Asaf66/Drone_ESP32/docs/Rev2_Design_Review.md

# סקירת תכנון – Drone_ESP32 Rev 2

תאריך: 2026-10-27. הבסיס: עותק של הקבצים בתיקייה הראשית כפי שהיו ב‑27/10 20:15, כולל השינויים שעוד לא נשמרו ב‑git (ראו "בסיס" למטה).
כלים: ‏kicad-cli 10.0.2 (ERC/DRC/netlist), ובדיקה ידנית מול הדאטהשיטים בתיקייה `DATA SHEET`.

## בסיס – מה כבר תוקן בתיקייה הראשית (לא ב‑git)
ב‑working tree יש שינויים מהיום מעבר ל‑commit ‏`cc9bfb0` (שהוא כנראה הלוח שיוצר):
- USB‑C: חיבור שני צמדי D+/D‑ ‏(A6+B6, A7+B7). בלוח v1 רק A6 ו‑B7 מחוברים, אז USB לא עובד באף כיוון של הכבל.
- CH340K: ‏V3 חובר ל‑+3V3 (הדאטהשיט: כש‑VCC=3.3V צריך לקצר את V3 ל‑VCC).
- SW1 הוחלף ל‑K3‑1280S‑F1 עם footprint מותאם, ו‑J4–J7 הוחלפו ל‑JST‑GH 1.25mm.
- תוקנו מק"טים ב‑BOM ‏(C6/C14–C16).
החיווט של השינויים האלה ב‑PCB לא גמור: D+/D‑ לא מחוברים בצד השני, יש מסלול +3V3 פתוח, ו‑SW1 מתנגש עם Q4/R17/R21/J4 ועם ויאות.

## שגיאות שנמצאו

| # | חומרה | איפה | הבעיה | תיקון מוצע |
|---|---|---|---|---|
| 1 | קריטי | U2 ‏CH340K | **D+ ו‑D‑ הפוכים.** לפי הדאטהשיט (ESSOP‑10) פין 1=UD+ ופין 2=UD‑. בסימבול פין 1 מסומן UD‑, וזה עבר גם ל‑PCB (פד 1=D‑). | לתקן את הסימבול, ולהצליב את המסלולים ליד U2 |
| 2 | קריטי | U1↔U2 UART | **TX מחובר ל‑TX ו‑RX ל‑RX.** ‏ESP32 TXD0 (פין 35) מחובר ל‑CH340 TXD (פין 8), ו‑RXD0 (פין 34) ל‑RXD (פין 9). גם שמות הנטים הפוכים. | להצליב: TXD0→RXD(9), ‏RXD0←TXD(8) |
| 3 | קריטי (תוקן בבסיס) | J1 USB‑C | B6/A7 לא מחוברים | תוקן בסכמה; צריך להשלים את ה‑routing |
| 4 | קריטי (תוקן בבסיס) | U2 V3 | V3 לא מחובר ל‑VCC | תוקן |
| 5 | גבוה | מנועים | המסלולים מה‑drain למנועים צרים: 0.25mm (M2, M3), ‏0.3mm (M4), ‏0.4mm (M1). מנוע coreless מושך 1–2A ויותר בהתנעה. | להרחיב ל‑≥0.8–1mm, או לשפוך פוליגון |
| 6 | גבוה | +BATT | יש רק 10µF (C8) על הסוללה. כשהמנועים מאיצים, המתח נופל וה‑ESP32 נכנס ל‑brownout. | להוסיף קבל bulk ‏(220–470µF, אלקטרוליטי/פולימר) ליד J2, ו‑10µF ליד כניסת ה‑LDO |
| 7 | בינוני | U4 TP4056 | VCC של המטען מגיע מ‑VBUS שאחרי D1 ו‑Q3. בלי USB, הסוללה מזינה את ה‑VCC של המטען. | להזין את VCC ואת נוריות CHG/STD מ‑+5V (USB) ישירות |
| 8 | בינוני | U3 LDO | אין קבל כניסה קרוב ל‑VIN ‏(C9 נמצא ~27mm משם, ליד U4). | להוסיף 1–10µF צמוד ל‑U3 |
| 9 | בינוני | J2 סוללה | ה‑footprint ב‑PCB הוא THT ‏`B2B-PH-K` אנכי, אבל ב‑BOM מופיע `B2B-PH-SM4-TB` ‏(SMD, ‏C160352). | ליישר לפי החלק שיש בפועל |
| 10 | בינוני | Q4–Q7 | בסכמה כתוב AO3400A, וב‑BOM ‏SI2302 ‏(C558245) עם שם footprint אחר | לבחור אחד ולייצר BOM מהסכמה |
| 11 | בינוני | SW1 (חדש) | החורים NPTH של המתג נוגעים בויאות/מסלולים, וה‑courtyard שלו חופף ל‑Q4/R17/R21/J4 (‏18 שגיאות DRC) | להזיז/לסדר מחדש את האזור |
| 12 | נמוך | VBATT_SENSE | מחלק 100k/100k בלי קבל ל‑ADC | להוסיף 100nF מ‑IO35 ל‑GND |
| 13 | נמוך | PWM_M2=IO14 | ‏IO14 מוציא PWM בזמן boot, אז מנוע 2 עלול לקפוץ בהדלקה | להחליף ל‑IO25/IO32/IO33 (פנויים) או להשאיר |
| 14 | נמוך | ERC/DRC | הוחרגו בדיקות חשובות: Board edge clearance, ו‑lib mismatch על 11 סימבולים "intentionally". ההחרגה הסתירה את שגיאה 1. | להחזיר את הבדיקות ולתעד החרגות אמיתיות |
| 15 | נמוך | silk | 14 חפיפות silk ו‑8 silk על pad | ניקוי |

## נבדק ותקין
פינאוט ESP32‑WROOM‑32E, ‏LSM6DS3 ‏(SPI), ‏LPS22HB ‏(I2C, CS→VDD, SA0→VDD), ‏AP2112K, ‏TP4056 ‏(TEMP→GND, PROG 2.2k≈540mA), ‏AO3401A power‑path, מעגל auto‑reset ‏(Q1/Q2), ‏strapping ‏(IO0/IO2/IO12/IO15/IO5), ‏CC1/CC2 5.1k, ‏flyback diodes, ‏gate pulldowns. האנטנה של ה‑ESP32 בולטת מעבר לשפיכת ה‑GND, ואין נחושת מתחתיה.

## סטטוס טיפול (2026-10-30)
- 5: בוצע (מסלולי מנוע 0.8mm).
- 6: בוצע. נוסף C17 ‏100µF 1210 DNP על +BATT/GND, מעל J2 בנקודה (165.5, 84.5); מחובר במסלול 0.8mm לטראנק +BATT, ו־GND דרך ה־zone. DRC: 0 שגיאות, 0 לא מחוברים.
- 11: בוצע (SW1 חזר ל־CAS-120A).
- חדש (2026-10-30): החריצים בזרועות (1.328 מ"מ) וה-notches ברגליים (1.30 מ"מ) צרים מעובי הלוח (1.6 מ"מ), ולכן הרגל לא נכנסת. בוצע: הורחבו ל-1.800 מ"מ (4 חריצים + 8 notches), באופן סימטרי, ב-Edge.Cuts בלבד. האורכים לא השתנו (חריץ 5.395, עומק notch).
- 7: הוחלט להשאיר (תפקודי; רק זליגה זניחה כשעובדים מהסוללה).
- 8: בוצע. C18 ‏10µF 0603 בצד התחתון, מתחת ל-U3, מחובר ב-via למסלול VBUS שליד פין 1 (מלחימים ידנית).
- 9 + 10: בוצע. BOM חדש `BOM.csv`: J2 = THT ‏B2B-PH-K; ‏SW1 = CAS-120A; ‏Q4–Q7 = SI2302 (גם בסכמה); ‏D2–D5 = 1N4148W (החלק שנקנה בפועל, C81598).
- 12: בוצע. C19 ‏100nF בצד התחתון, ישירות על מסלול VBATT_SENSE ליד U1.
- 13: בוצע. PWM_M2 הועבר מ-IO14 ל-**IO12** (פין 14). ל-IO12 יש pulldown של 10K על השער, ולכן הוא LOW באתחול, כמו שצריך. via של +3V3 הוזז 0.75 מ"מ. **בקושחה: מנוע 2 = GPIO12 בלוח v2 (בלוח 1 הוא GPIO14).**
- 14: בוצע. copper_edge_clearance הופעל מחדש, ונוסף `Drone_ESP32.kicad_dru` שפוטר רק את פדי ההלחמה של המפרקים (גרפיקה ללא net). בדיקת שפיות עם 2 מ"מ עדיין תופסת פדים ומסלולים. ב-ERC נשארו רק אזהרות lib_symbol_mismatch.
- 15: בוצע. DRC מראה 0 אזהרות סילק.

## מוכן להזמנה (2026-10-30)
- קובץ: `Gerbers/Drone_ESP32_JLCPCB.zip` (Gerbers + PTH/NPTH, אותם קבצים ופורמט כמו בהזמנה הקודמת).
- DRC: אפס שגיאות ואפס חיבורים חסרים. Parity: רק לוגו ופידוצ'יאלים.
- נבדק ב-X2 של הגרברים: USB D+/D-, ‏CH340 D+/D-, ‏TX/RX מוצלבים, ‏V3=VCC, ‏PWM_M2 על IO12, ‏C17/C18/C19.
- F.Paste: כל 257 הפתחים זהים להזמנה המקורית, כך שהסטנסיל הקיים מתאים (נוספו רק 2 פדים של C17, שהוא DNP).
