Asaf66/Drone_ESP32/images/3D_View.png

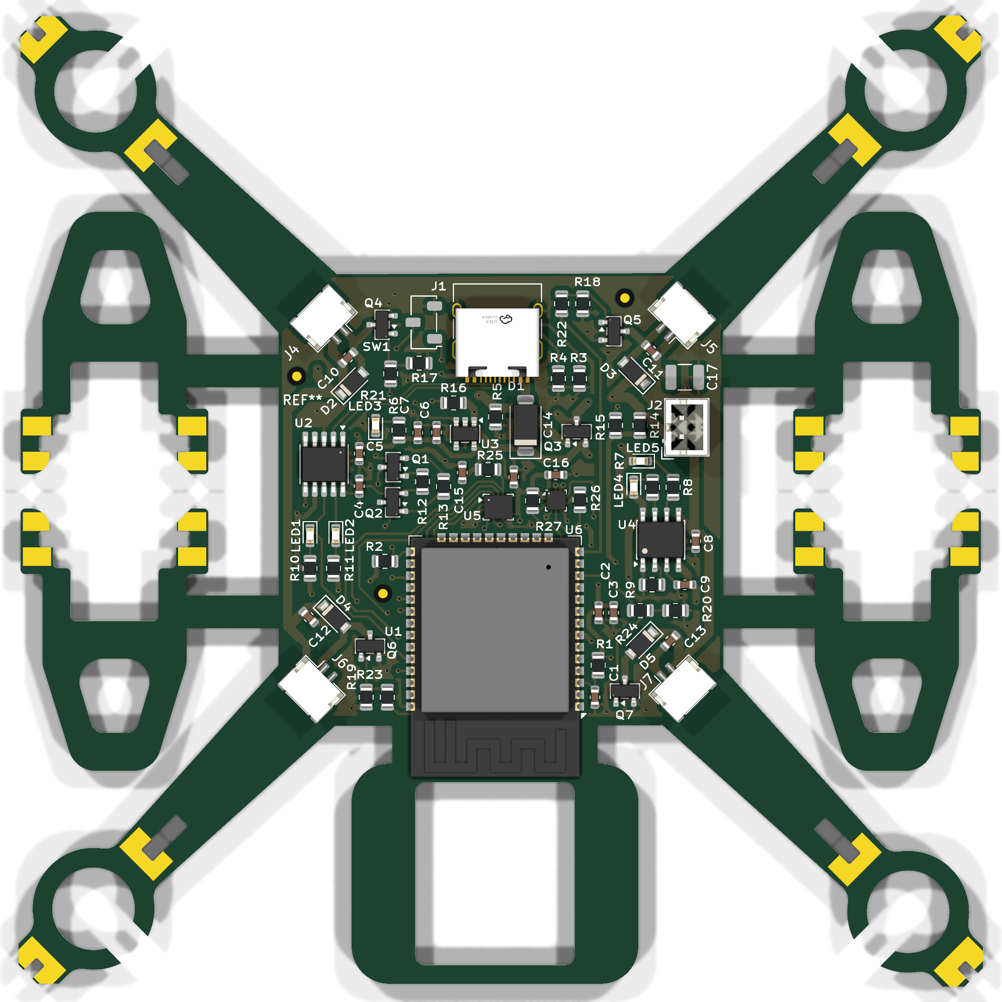
images/3D_View.png
