Asaf66/Drone_ESP32/BOM.csv

Comment | Designator | Footprint | JLCPCB Part #（optional） | Quantity
1u | C1 | C_0603_1608Metric | C15849 | 1
100u DNP (not fitted) | C17 | C_1210_3225Metric |  | 0
10u | C2, C7, C8, C9, C18 | C_0603_1608Metric | C19702 | 5
0.1u | C3, C4, C5, C10, C11, C12, C13 | C_0603_1608Metric | C14663 | 7
2.2u | C6 | C_0603_1608Metric | C23630 | 1
100n | C14, C15, C16, C19 | C_0603_1608Metric | C14663 | 4
SS34 | D1 | D_SMA | C8678 | 1
1N4148W | D2, D3, D4, D5 | Nexperia_CFP3_SOD-123W | C81598 | 4
USB_C_Receptacle_USB2.0_16P | J1 | USB_C_Receptacle_HRO_TYPE-C-31-M-12 | C393939 | 1
JST PH 2P vertical THT (B2B-PH-K-S) | J2 | JST_PH_B2B-PH-K_1x02_P2.00mm_Vertical |  | 1
Conn_01x02_Socket | J4, J5, J6, J7 | JST_GH_SM02B-GHS-TB_1x02-1MP_P1.25mm_Horizontal | C54582897 | 4
D_TX | LED1 | LED_0603_1608Metric | C2290 | 1
D_RX | LED2 | LED_0603_1608Metric | C2290 | 1
POW_LED | LED3 | LED_0603_1608Metric | C2290 | 1
CHG | LED4 | LED_0603_1608Metric | C118330 | 1
STD | LED5 | LED_0603_1608Metric | C965804 | 1
BC817 | Q1, Q2 | SOT-23 | C475629 | 2
AO3401A | Q3 | SOT-23 | C15127 | 1
SI2302 (VBsemi SI2302DS-T1-GE3-VB) | Q4, Q5, Q6, Q7 | SOT-23 | C558245 | 4
10K | R1, R2, R12, R13, R17, R18, R19, R20, R25 | R_0805_2012Metric | C17414 | 9
5K1 | R3, R4 | R_0805_2012Metric | C27834 | 2
100K | R5, R14, R15, R16 | R_0805_2012Metric | C149504 | 4
470R | R6, R7, R8 | R_0805_2012Metric | C17710 | 3
2.2K | R9 | R_0805_2012Metric | C17520 | 1
220R | R10, R11 | R_0805_2012Metric | C17557 | 2
47R | R21, R22, R23, R24 | R_0805_2012Metric | C17714 | 4
4K7 | R26, R27 | R_0805_2012Metric | C17673 | 2
Nidec CAS-120A (SPDT slide) | SW1 | Nidec_Copal_CAS-120A | C5962834 | 1
ESP32-WROOM-32E | U1 | ESP32-WROOM-32E | C701342 | 1
CH340K | U2 | SSOP-10-1EP_3.9x4.9mm_P1mm_EP2.1x3.3mm | C18208922 | 1
AP2112K-3.3 | U3 | SOT-23-5 | C23380830 | 1
TP4056-42-ESOP8 | U4 | SOIC-8-1EP_3.9x4.9mm_P1.27mm_EP2.41x3.3mm_ThermalVias | C16581 | 1
LSM6DS3 | U5 | LGA-14_3x2.5mm_P0.5mm_LayoutBorder3x4y | C967633 | 1
LPS22HB | U6 | ST_HLGA-10_2x2mm_P0.5mm_LayoutBorder3x2y | C94049 | 1
