Asaf66/Drone_ESP32/Drone_ESP32.kicad_pcb

## KiCad design Drone_ESP32.kicad_pcb (2026-11-02)

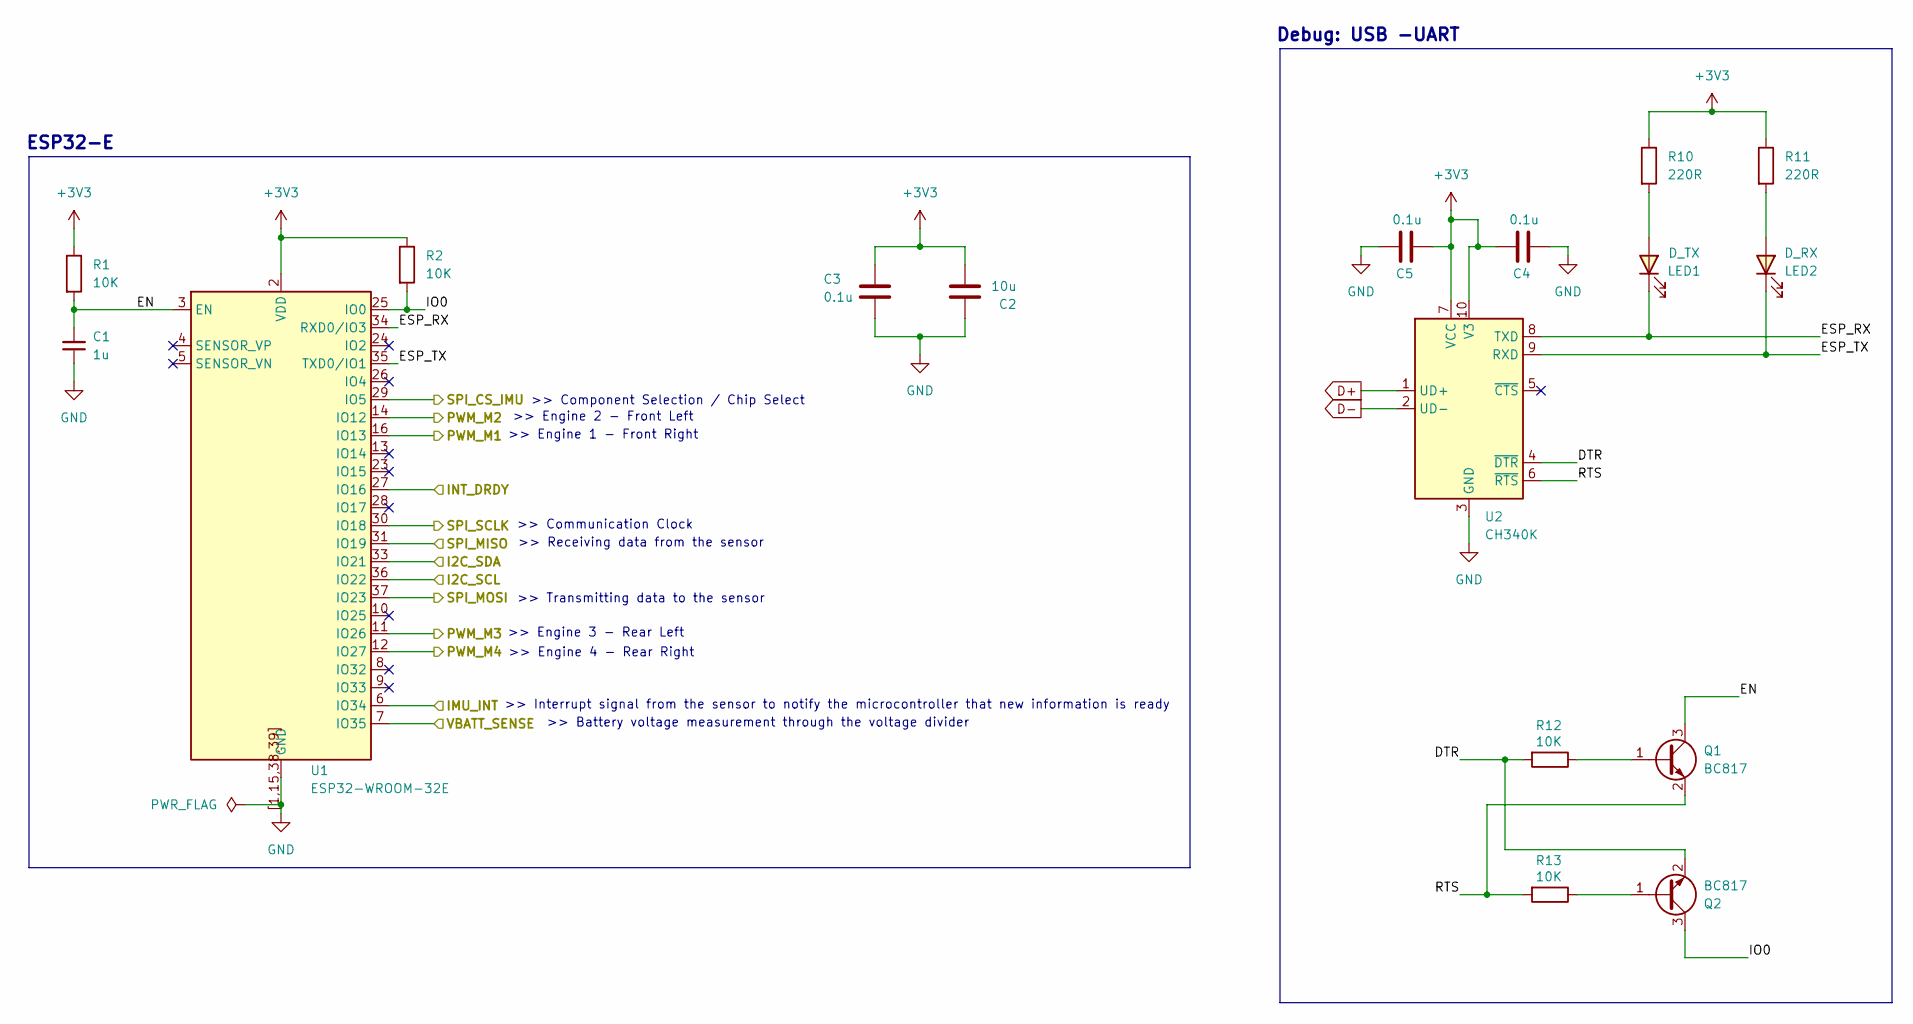
[picture p12: schematic ESP32_Core.kicad_sch, 01 - ESP32 Core & Connectivity (page 2)]

Parts:
C1: 1u; C_0603_1608Metric
C2: 10u; C_0603_1608Metric
C3, C4, C5: 0.1u; C_0603_1608Metric
LED1: D_TX; LED_0603_1608Metric
LED2: D_RX; LED_0603_1608Metric
Q1, Q2: BC817; SOT-23
R1, R2, R12, R13: 10K; R_0805_2012Metric
R10, R11: 220R; R_0805_2012Metric
U1: ESP32-WROOM-32E
U2: CH340K; SSOP-10-1EP_3.9x4.9mm_P1mm_EP2.1x3.3mm

Connections:
+3V3: C2.1, C3.2, C4.1, C5.2, R1.1, R2.1, R10.1, R11.1, U1.2 (VDD), U2.7 (VCC), U2.10 (V3); also elsewhere on the board
/01 - ESP32 Core & Connectivity (page 2)/DTR: Q2.2 (E), R12.2, U2.4 (~DTR)
/01 - ESP32 Core & Connectivity (page 2)/EN: C1.2, Q1.3 (C), R1.2, U1.3 (EN)
/01 - ESP32 Core & Connectivity (page 2)/ESP_RX: LED1.1 (K), U1.34 (RXD0/IO3), U2.8 (TXD)
/01 - ESP32 Core & Connectivity (page 2)/ESP_TX: LED2.1 (K), U1.35 (TXD0/IO1), U2.9 (RXD)
/01 - ESP32 Core & Connectivity (page 2)/I2C_SCL: U1.36 (IO22); also elsewhere on the board
/01 - ESP32 Core & Connectivity (page 2)/I2C_SDA: U1.33 (IO21); also elsewhere on the board
/01 - ESP32 Core & Connectivity (page 2)/IMU_INT: U1.6 (IO34); also elsewhere on the board
/01 - ESP32 Core & Connectivity (page 2)/INT_DRDY: U1.27 (IO16); also elsewhere on the board
/01 - ESP32 Core & Connectivity (page 2)/IO0: Q2.3 (C), R2.2, U1.25 (IO0)
/01 - ESP32 Core & Connectivity (page 2)/PWM_M1: U1.16 (IO13); also elsewhere on the board
/01 - ESP32 Core & Connectivity (page 2)/PWM_M2: U1.14 (IO12); also elsewhere on the board
/01 - ESP32 Core & Connectivity (page 2)/PWM_M3: U1.11 (IO26); also elsewhere on the board
/01 - ESP32 Core & Connectivity (page 2)/PWM_M4: U1.12 (IO27); also elsewhere on the board
/01 - ESP32 Core & Connectivity (page 2)/RTS: Q1.2 (E), R13.2, U2.6 (~RTS)
/01 - ESP32 Core & Connectivity (page 2)/SPI_CS_IMU: U1.29 (IO5); also elsewhere on the board
/01 - ESP32 Core & Connectivity (page 2)/SPI_MISO: U1.31 (IO19); also elsewhere on the board
/01 - ESP32 Core & Connectivity (page 2)/SPI_MOSI: U1.37 (IO23); also elsewhere on the board
/01 - ESP32 Core & Connectivity (page 2)/SPI_SCLK: U1.30 (IO18); also elsewhere on the board
/01 - ESP32 Core & Connectivity (page 2)/VBATT_SENSE: U1.7 (IO35); also elsewhere on the board
D+: U2.1 (UD-); also elsewhere on the board
D-: U2.2 (UD+); also elsewhere on the board
GND: C1.1, C2.2, C3.1, C4.2, C5.1, U1.1 (GND), U1.15 (GND), U1.38 (GND), U1.39 (GND), U1.[1,15,38,39] (GND), U2.3 (GND), U2.11 (GND); also elsewhere on the board
unnamed: LED1.2 (A), R10.2
unnamed: LED2.2 (A), R11.2
unnamed: Q1.1 (B), R12.1
unnamed: Q2.1 (B), R13.1

Notes on the sheet:
>> Interrupt signal from the sensor to notify the microcontroller that new information is ready
>> Communication Clock
Debug: USB -UART
>> Engine 2 - Front Left
ESP32-E
>> Engine 3 - Rear Left
>> Engine 1 - Front Right
>> Receiving data from the sensor
>> Component Selection / Chip Select
>> Engine 4 - Rear Right
>> Transmitting data to the sensor
>> Battery voltage measurement through the voltage divider

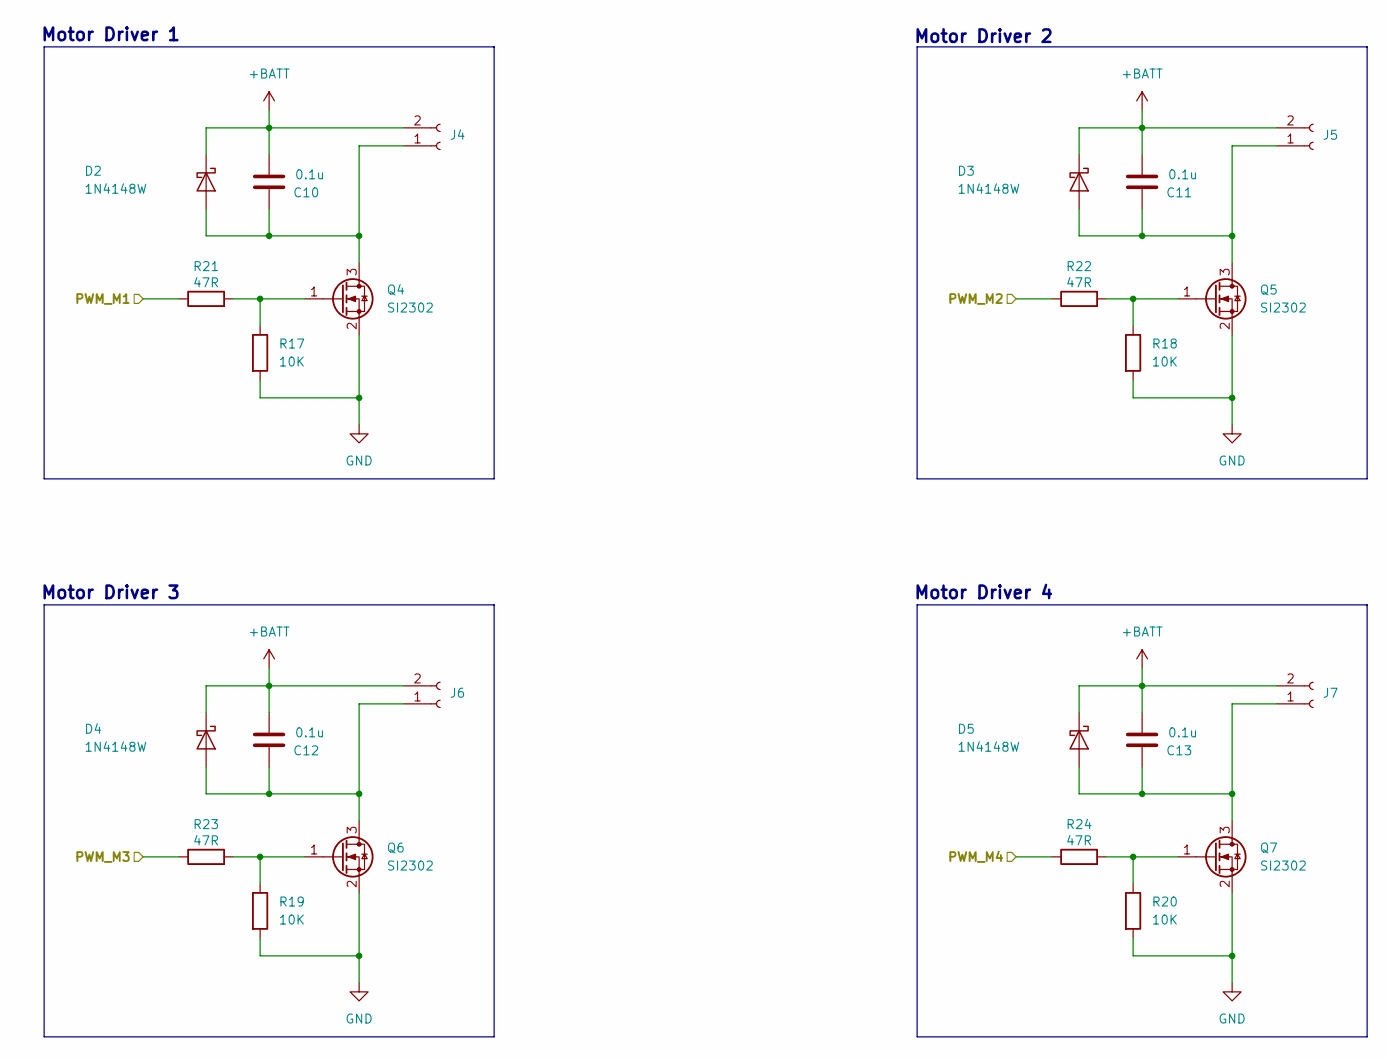
[picture p13: schematic Motor_Drivers.kicad_sch, 03 - Motor Drivers & EMI Protection (page 4)]

Parts:
C10, C11, C12, C13: 0.1u; C_0603_1608Metric
D2, D3, D4, D5: 1N4148W; Nexperia_CFP3_SOD-123W
J4, J5, J6, J7: Conn_01x02_Socket; JST_GH_SM02B-GHS-TB_1x02-1MP_P1.25mm_Horizontal
Q4, Q5, Q6, Q7: SI2302; SOT-23
R17, R18, R19, R20: 10K; R_0805_2012Metric
R21, R22, R23, R24: 47R; R_0805_2012Metric

Connections:
+BATT: C10.1, C11.1, C12.1, C13.1, D2.1 (K), D3.1 (K), D4.1 (K), D5.1 (K), J4.2, J5.2, J6.2, J7.2; also elsewhere on the board
/01 - ESP32 Core & Connectivity (page 2)/PWM_M1: R21.1; also elsewhere on the board
/01 - ESP32 Core & Connectivity (page 2)/PWM_M2: R22.1; also elsewhere on the board
/01 - ESP32 Core & Connectivity (page 2)/PWM_M3: R23.1; also elsewhere on the board
/01 - ESP32 Core & Connectivity (page 2)/PWM_M4: R24.1; also elsewhere on the board
GND: Q4.2 (S), Q5.2 (S), Q6.2 (S), Q7.2 (S), R17.2, R18.2, R19.2, R20.2; also elsewhere on the board
unnamed: C10.2, D2.2 (A), J4.1, Q4.3 (D)
unnamed: C11.2, D3.2 (A), J5.1, Q5.3 (D)
unnamed: C12.2, D4.2 (A), J6.1, Q6.3 (D)
unnamed: C13.2, D5.2 (A), J7.1, Q7.3 (D)
unnamed: Q4.1 (G), R17.1, R21.2
unnamed: Q5.1 (G), R18.1, R22.2
unnamed: Q6.1 (G), R19.1, R23.2
unnamed: Q7.1 (G), R20.1, R24.2

Notes on the sheet:
Motor Driver 4
Motor Driver 2
Motor Driver 1
Motor Driver 3

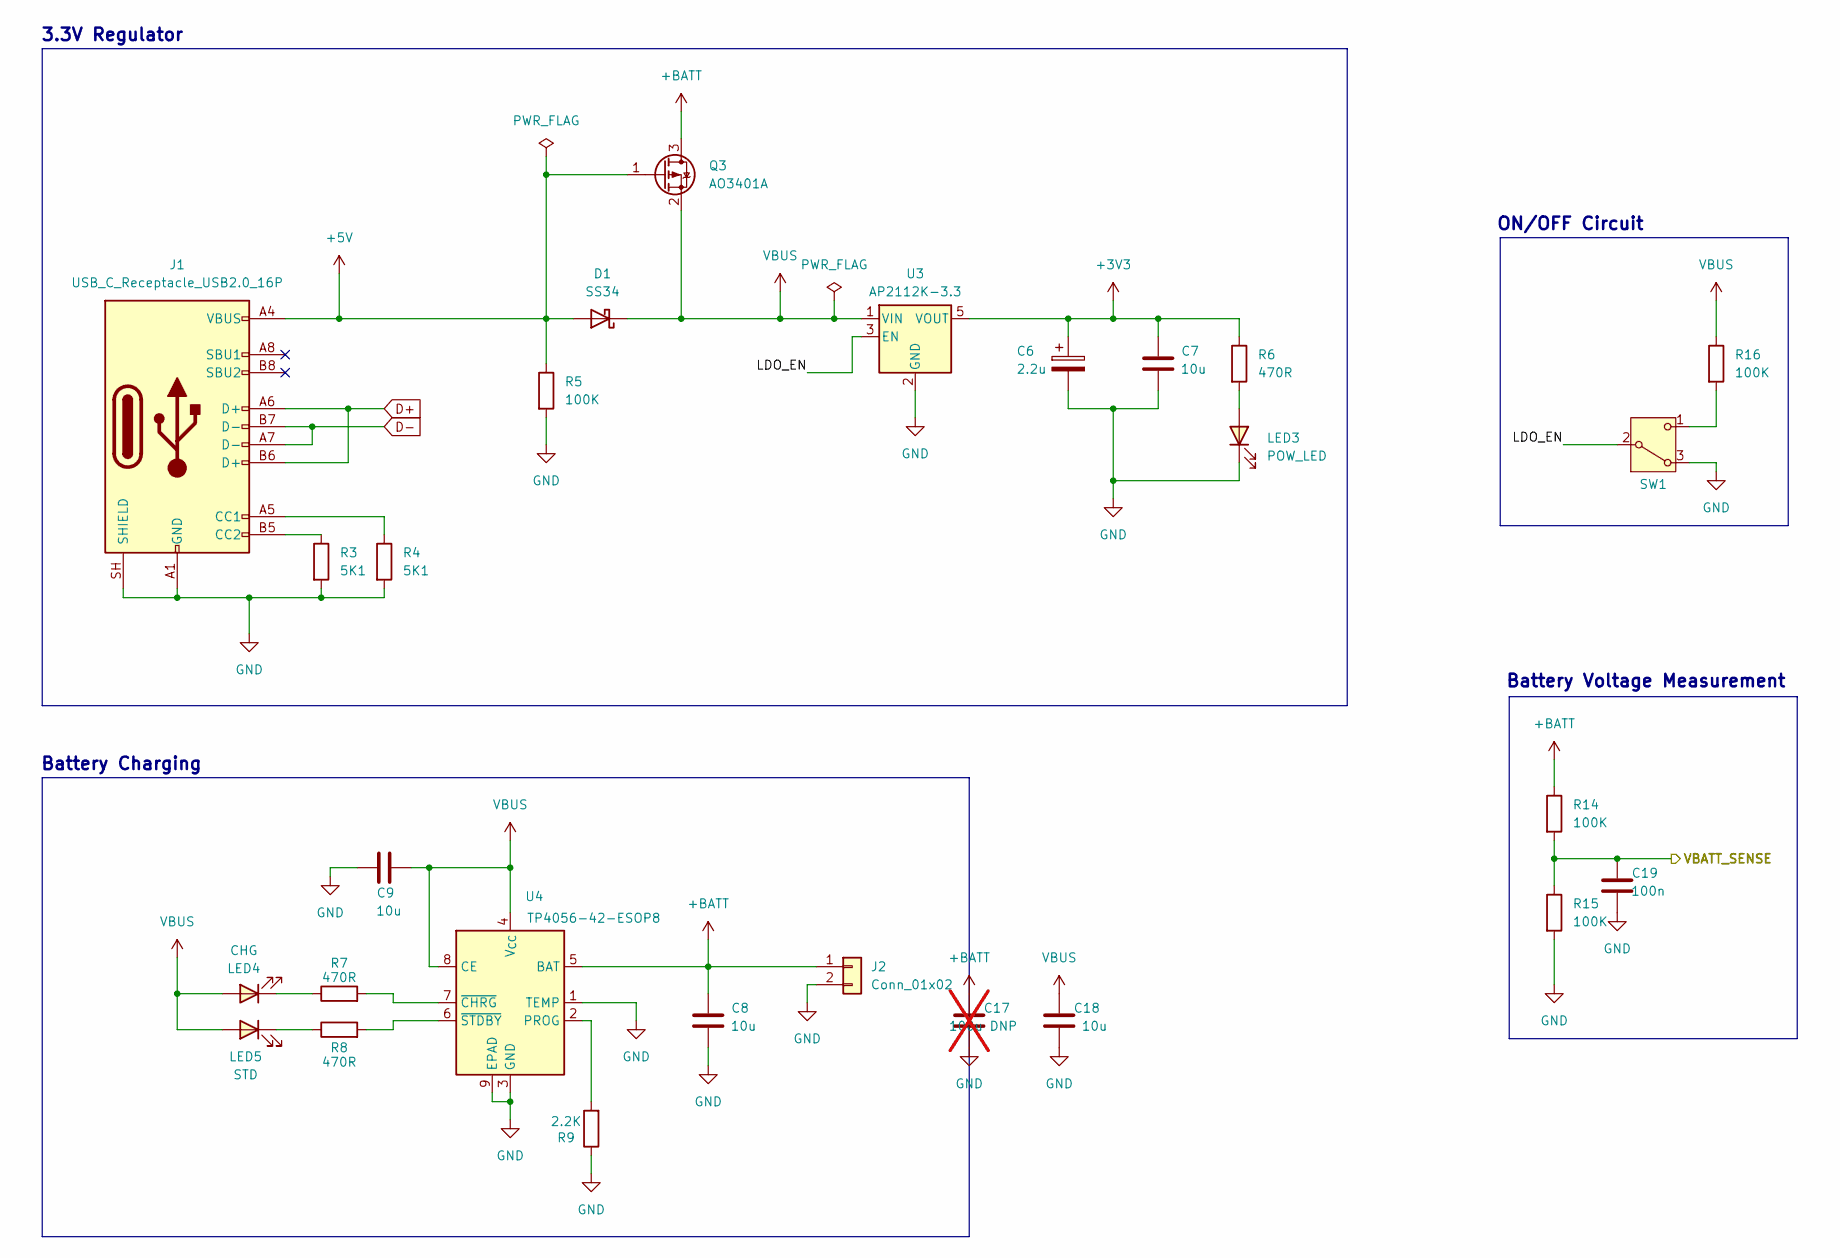
[picture p14: schematic Power_Management.kicad_sch, 02 - Power Management & LiPo (page 3)]

Parts:
C6: 2.2u; C_0603_1608Metric
C7, C8, C9, C18: 10u; C_0603_1608Metric
C17: 100u DNP; C_1210_3225Metric; not fitted
C19: 100n; C_0603_1608Metric
D1: SS34; D_SMA
J1: USB_C_Receptacle_USB2.0_16P; USB_C_Receptacle_HRO_TYPE-C-31-M-12
J2: Conn_01x02; JST_PH_B2B-PH-K_1x02_P2.00mm_Vertical
LED3: POW_LED; LED_0603_1608Metric
LED4: CHG; LED_0603_1608Metric
LED5: STD; LED_0603_1608Metric
Q3: AO3401A; SOT-23
R3, R4: 5K1; R_0805_2012Metric
R5, R14, R15, R16: 100K; R_0805_2012Metric
R6, R7, R8: 470R; R_0805_2012Metric
R9: 2.2K; R_0805_2012Metric
SW1: CAS-120A1; Nidec_Copal_CAS-120A
U3: AP2112K-3.3; SOT-23-5
U4: TP4056-42-ESOP8; SOIC-8-1EP_3.9x4.9mm_P1.27mm_EP2.41x3.3mm_ThermalVias

Connections:
+3V3: C6.1, C7.1, R6.1, U3.5 (VOUT); also elsewhere on the board
+5V: D1.2 (A), J1.A4 (VBUS), J1.A9 (VBUS), J1.B4 (VBUS), J1.B9 (VBUS), Q3.1 (G), R5.1
+BATT: C8.1, C17.1, J2.1, Q3.3 (D), R14.1, U4.5 (BAT); also elsewhere on the board
/01 - ESP32 Core & Connectivity (page 2)/VBATT_SENSE: C19.1, R14.2, R15.1; also elsewhere on the board
/02 - Power Management & LiPo/LDO_EN: SW1.2 (B), U3.3 (EN)
D+: J1.A6 (D+), J1.B6 (D+); also elsewhere on the board
D-: J1.A7 (D-), J1.B7 (D-); also elsewhere on the board
GND: C6.2, C7.2, C8.2, C9.2, C17.2, C18.2, C19.2, J1.A1 (GND), J1.A12 (GND), J1.B1 (GND), J1.B12 (GND), J1.SH (SHIELD), J2.2, LED3.1 (K), R3.2, R4.2, R5.2, R9.1, R15.2, SW1.3 (A), U3.2 (GND), U4.1 (TEMP), U4.3 (GND), U4.9 (EPAD); also elsewhere on the board
unnamed: J1.A5 (CC1), R4.1
unnamed: J1.B5 (CC2), R3.1
unnamed: LED3.2 (A), R6.2
unnamed: LED4.1 (K), R7.1
unnamed: LED5.1 (K), R8.1
unnamed: R16.2, SW1.1 (C)
unnamed: R9.2, U4.2 (PROG)
unnamed: R7.2, U4.7 (~CHRG)
unnamed: R8.2, U4.6 (~STDBY)
VBUS: C9.1, C18.1, D1.1 (K), LED4.2 (A), LED5.2 (A), Q3.2 (S), R16.1, U3.1 (VIN), U4.4 (V_{CC}), U4.8 (CE)

Notes on the sheet:
ON/OFF Circuit
Battery Charging
Battery Voltage Measurement
3.3V Regulator

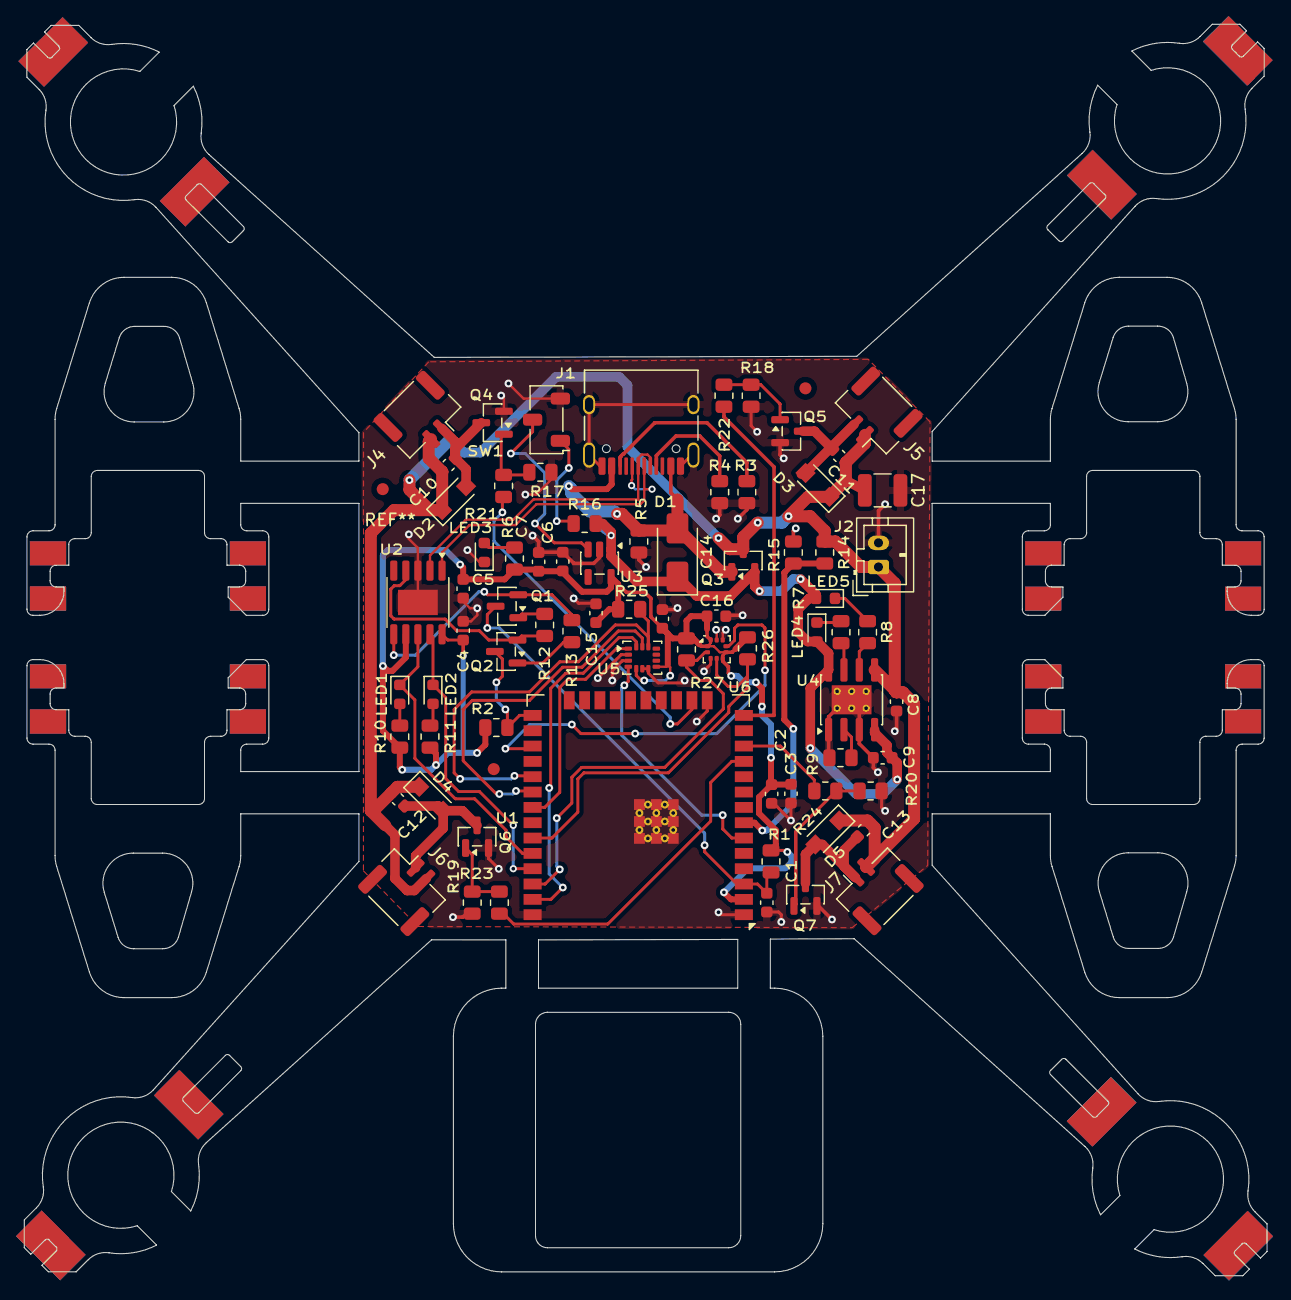
[picture p15: board Drone_ESP32.kicad_pcb from above]

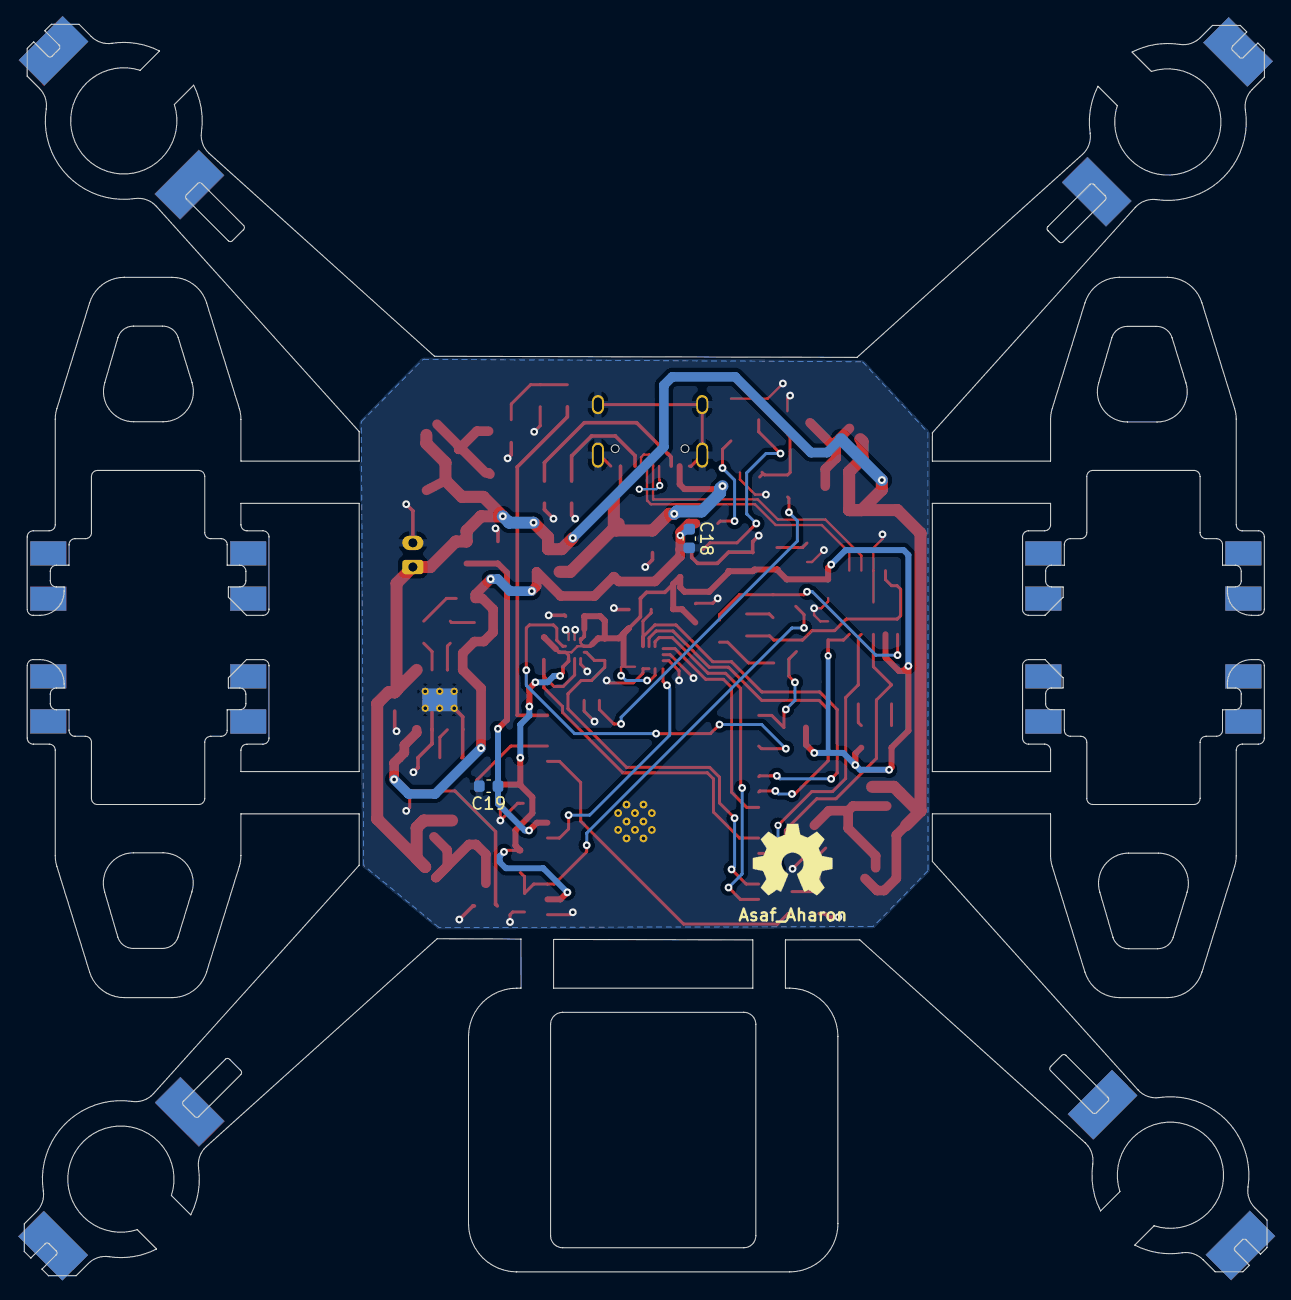
[picture p16: board Drone_ESP32.kicad_pcb from below]

Board: 2 copper layers, 102.9 x 103.7 mm, 76 parts (2 on the bottom side), 48 nets.

Other parts of the board:
C14, C15, C16: 100n; C_0603_1608Metric
R25: 10K; R_0805_2012Metric
R26, R27: 4K7; R_0805_2012Metric
U5: LSM6DS3; LGA-14_3x2.5mm_P0.5mm_LayoutBorder3x4y
U6: LPS22HB; ST_HLGA-10_2x2mm_P0.5mm_LayoutBorder3x2y

Their connections:
+3V3: C14.1, C15.2, C16.1, R25.1, R26.1, R27.1, U5.5 (VDDIO), U5.8 (VDD), U6.1 (Vdd_IO), U6.5 (SA0), U6.6 (~CS), U6.10 (VDD); also elsewhere on the board
/01 - ESP32 Core & Connectivity (page 2)/I2C_SCL: R27.2, U6.2 (SCL); also elsewhere on the board
/01 - ESP32 Core & Connectivity (page 2)/I2C_SDA: R26.2, U6.4 (SDA); also elsewhere on the board
/01 - ESP32 Core & Connectivity (page 2)/IMU_INT: U5.4 (INT1); also elsewhere on the board
/01 - ESP32 Core & Connectivity (page 2)/INT_DRDY: U6.7 (INT_DRDY); also elsewhere on the board
/01 - ESP32 Core & Connectivity (page 2)/SPI_CS_IMU: R25.2, U5.12 (CS); also elsewhere on the board
/01 - ESP32 Core & Connectivity (page 2)/SPI_MISO: U5.1 (SDO/SA0); also elsewhere on the board
/01 - ESP32 Core & Connectivity (page 2)/SPI_MOSI: U5.14 (SDA); also elsewhere on the board
/01 - ESP32 Core & Connectivity (page 2)/SPI_SCLK: U5.13 (SCL); also elsewhere on the board
GND: C14.2, C15.1, C16.2, U5.2 (SDX), U5.3 (SCX), U5.6 (GND), U5.7 (GND), U6.3 (GND), U6.8 (GND), U6.9 (GND); also elsewhere on the board
