Asaf66/Drone_ESP32/(commit log)

2026-09-22 Initial commit: Drone_ESP32 KiCad project
    [BOM.csv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]
2026-09-22 Add README with renders, block diagram, and BOM overview
2026-11-02 Add rev2 board (v2/): design fixes, ready-to-order Gerbers
    Electrical fixes vs. the as-ordered Rev1 board:
    - USB-C: tie A6/B6 (D+) and A7/B7 (D-)
    - CH340K: fix swapped D+/D-, cross TX/RX with ESP32, tie V3 to VCC
    - Motor drain traces widened to 0.8 mm
    - PWM_M2 moved from IO14 (PWM glitch at boot) to IO12
    - Added C17 100u 1210 DNP bulk cap on +BATT near J2
    - Added C18 10u (bottom) at AP2112K input, C19 100n (bottom) on VBATT_SENSE
    Mechanical / fab:
    - Arm slots and leg notches widened 1.33 -> 1.80 mm to fit 1.6 mm board
    - SW1 back to Nidec CAS-120A footprint
    - copper_edge_clearance re-enabled; custom rule exempts only joint pads
    - All top-side footprints unchanged, so the Rev1 stencil still f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
    [BOM_v2.csv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]
2026-11-02 Add up-to-date v2 schematic images
    The images in תמונות/ are screenshots of the original Rev1 schematic.
    These are rendered from the v2 schematic (USB A6/B6 and A7/B7 tied,
    CH340K D+/D- and TX/RX fixed, PWM_M2 on IO12, C18/C19 added).
2026-11-02 Make Rev 2 the only published version of the board
    - Move the Rev 2 KiCad project from v2/ to the repository root
    - Remove the Rev 1 project files, old Gerbers, BOM/CPL and old images
    - Gerbers/ now holds the Rev 2 Gerbers, drill files and JLCPCB zip
    - Regenerate BOM.csv (Rev 2) and CPL.csv (JLCPCB format) from the board
    - images/: new renders, F.Cu/B.Cu layout and schematic exports from Rev 2
    - docs/Rev2_Design_Review.md: the full design review
    - Fix the "Engine 2" note on sheet 01 to sit next to IO12 (PWM_M2)
    - Plot output directory set to Gerbers/
    - README updated for Rev 2 (pin map, revision notes, manufacturing)
    - .gitignore: keep local working folders out of the repository
    Rev 1 remai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
    [BOM.csv, BOM_v2.csv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]
